santosjoaop/fm-radio-receiver/docs/diagrams/Fluxograma da função ScanTotal().png

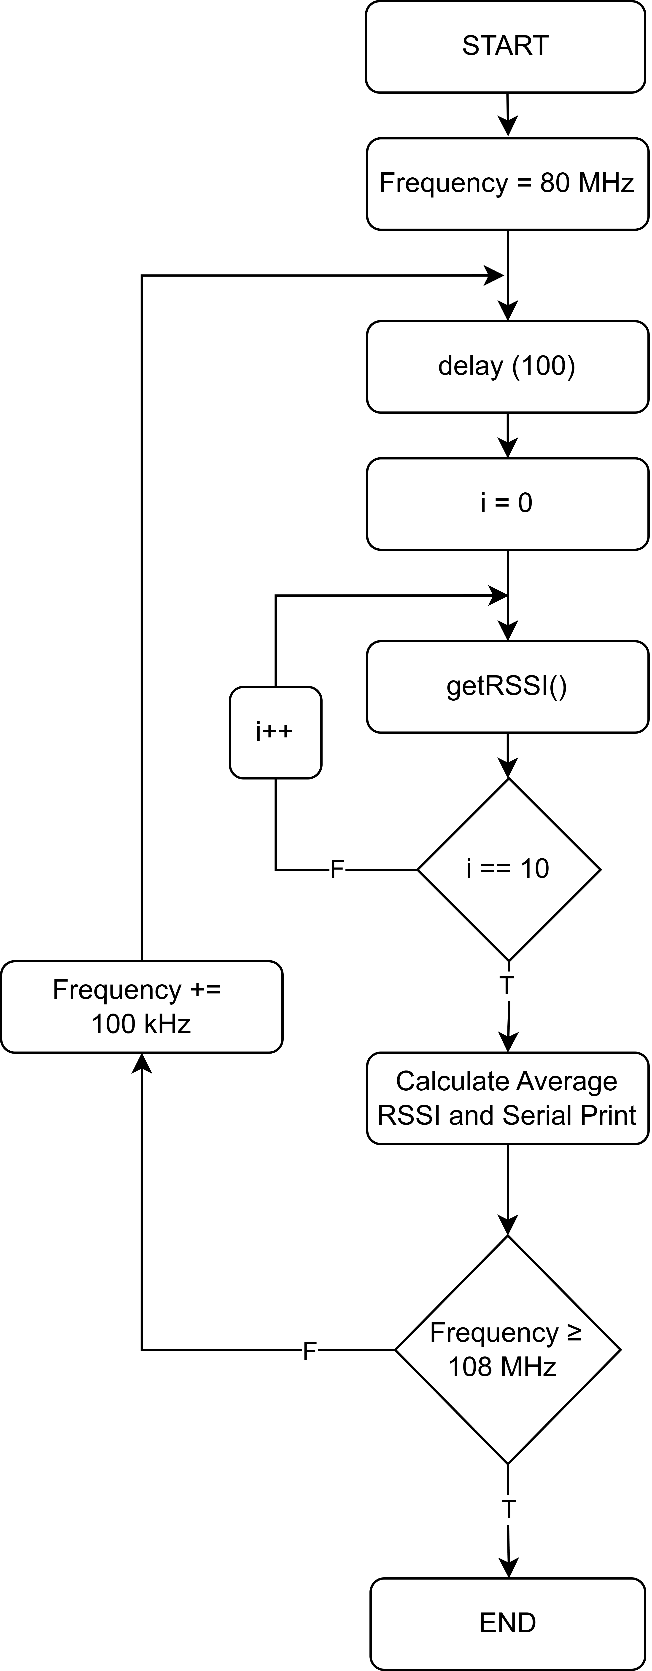
docs/diagrams/Fluxograma da função ScanTotal().png
