santosjoaop/fm-radio-receiver/docs/diagrams/Fluxograma do ScanFrequencies.png

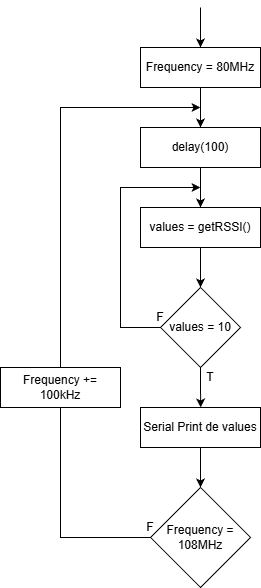
docs/diagrams/Fluxograma do ScanFrequencies.png
