santosjoaop/fm-radio-receiver/docs/diagrams/UML de Classes.png

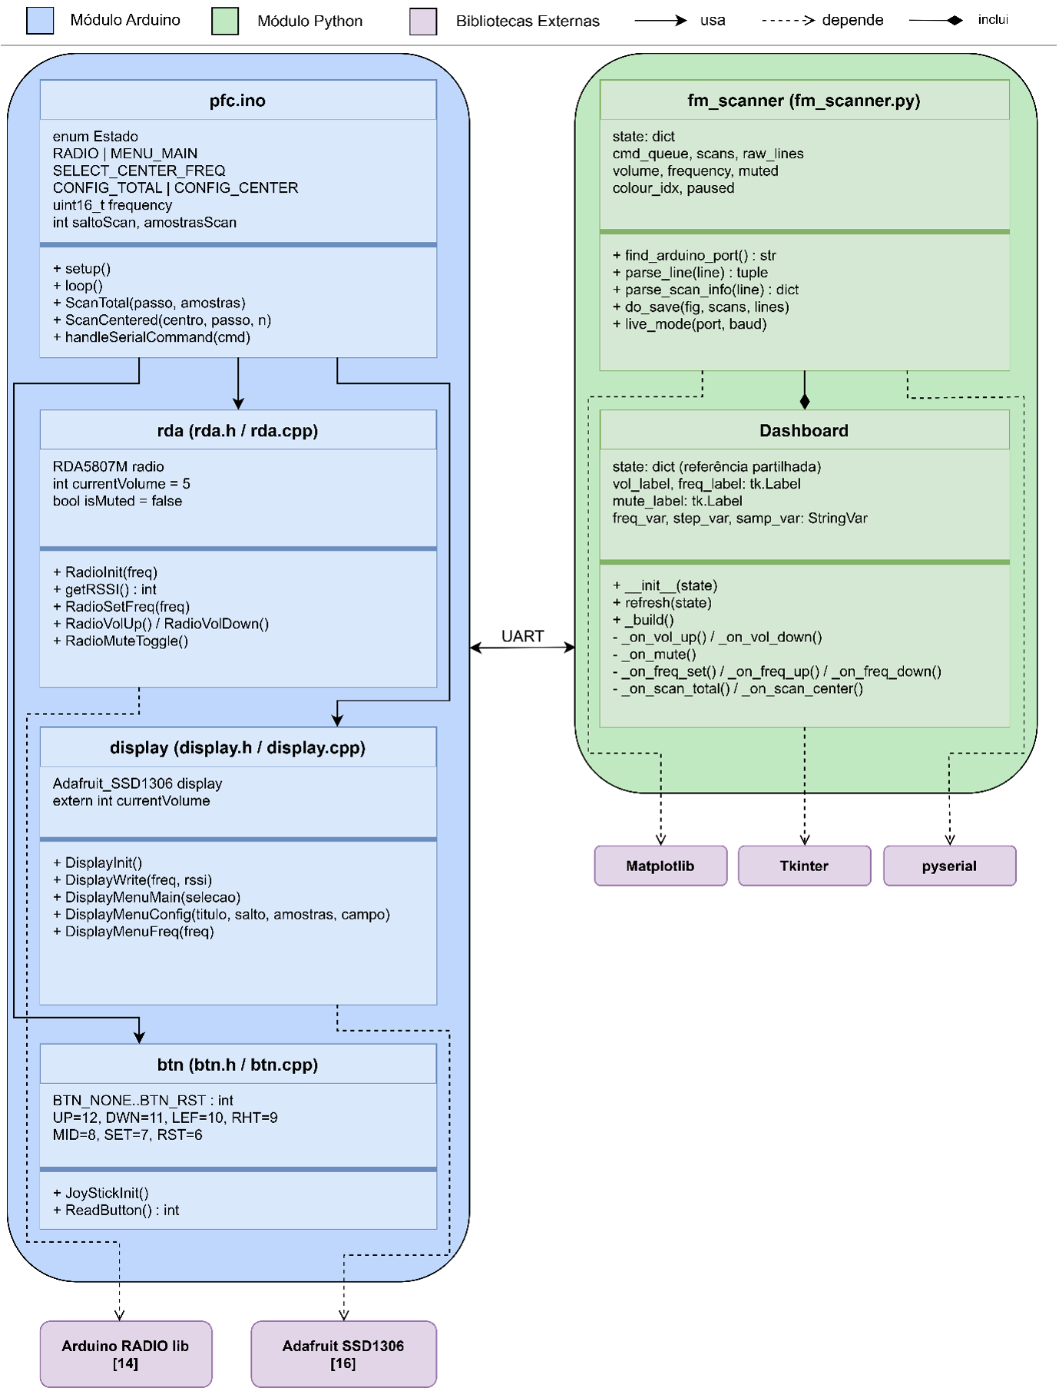
docs/diagrams/UML de Classes.png
