santosjoaop/fm-radio-receiver/(commit log)

2026-05-15 Add joystick button functions in btn_func.cpp
    Implement joystick initialization and button reading functions.
2026-05-15 Add btn_func.h for joystick button definitions
